GAULAvionique/ABRARACOURCIX_HARD_ware/README.md

# PCB_CTRL_Surface
Le design du hardware qui assurera le contrôle de surface pour le drone prototype.
