GAULAvionique/ABRARACOURCIX_HARD_ware/ABRARACOURCIX_main_board/BOM_ABRARACOURCIX.xlsx

Reference | Quantity | Order quantity | Value | Footprint | Digikey link | Digikey part number | Description
C11 | 1 | 1 | 10u | Librairie_footprint:CAP_MU_15750_RUB-L | https://www.digikey.ca/en/products/detail/rubycon/16MU106MC44532/4969517 | 1189-2511-6-ND | Unpolarized film capacitor
C12 | 1 | 10 | 100nF | Capacitor_SMD:C_1206_3216Metric_Pad1.33x1.80mm_HandSolder | https://www.digikey.ca/en/products/detail/walsin-technology-corporation/1206B104K500CT/9355102 | 1292-1605-1-ND | Unpolarized capacitor
C14, C15 | 2 | 10 | 22pF | Capacitor_SMD:C_1206_3216Metric_Pad1.33x1.80mm_HandSolder | https://www.digikey.ca/en/products/detail/kemet/C1206C220K1GACTU/2215429 | 399-C1206C220K1GACTUCT-ND | Unpolarized capacitor
C17 | 1 | 10 | 1n | Capacitor_SMD:C_1206_3216Metric_Pad1.33x1.80mm_HandSolder | https://www.digikey.ca/en/products/detail/walsin-technology-corporation/1206B102K500CT/9355095 | 1292-1598-1-ND | Unpolarized capacitor
C18 | 1 | 10 | 10u | Capacitor_SMD:C_1206_3216Metric_Pad1.33x1.80mm_HandSolder | https://www.digikey.ca/en/products/detail/walsin-technology-corporation/1206X106K250CT/14836856 | 1292-1206X106K250CT-ND | Unpolarized capacitor
C19, C21 | 2 | 10 | 22u | Capacitor_SMD:C_1206_3216Metric_Pad1.33x1.80mm_HandSolder | https://www.digikey.ca/en/products/detail/walsin-technology-corporation/1206X226M160CT/9341705 | 1292-1206X226M160CT-ND | Unpolarized capacitor
C1-C3, C5, C6, C16 | 6 | 10 | 100n | Capacitor_SMD:C_1206_3216Metric_Pad1.33x1.80mm_HandSolder | Link (https://www.digikey.ca/en/products/detail/walsin-technology-corporation/1206B104K500CT/9355102) | 1292-1605-1-ND | Unpolarized capacitor
C4, C10, C13, C20 | 4 | 10 | 1u | Capacitor_SMD:C_1206_3216Metric_Pad1.33x1.80mm_HandSolder | https://www.digikey.ca/en/products/detail/walsin-technology-corporation/1206B105K250CT/15986617 | 1292-1206B105K250CT-ND | Unpolarized capacitor
C7 | 1 | 10 | 4.7u | Capacitor_SMD:C_1206_3216Metric_Pad1.33x1.80mm_HandSolder | https://www.digikey.ca/en/products/detail/walsin-technology-corporation/1206B475K250CT/14836816 | 1292-1206B475K250CT-ND | Unpolarized capacitor
C8, C9 | 2 | 10 | 2.2u | Capacitor_SMD:C_1206_3216Metric_Pad1.33x1.80mm_HandSolder | https://www.digikey.ca/en/products/detail/walsin-technology-corporation/1206B225K250CT/15980646 | 1292-1206B225K250CT-ND | Unpolarized capacitor
D1, D2 | 2 | 10 | 599-0410-127F | Diode_SMD:D_1206_3216Metric_Pad1.42x1.75mm_HandSolder | https://www.digikey.ca/en/products/detail/dialight/599-0410-127F/21710495 | 350-599-0410-127FCT-ND | Light emitting diode
DZ1 | 1 | 10 | SZMMSZ4679T1G | Diode_SMD:D_SOD-123 | https://www.digikey.ca/en/products/detail/onsemi/SZMMSZ4679T1G/5404986 | SZMMSZ4679T1GOSCT-ND | 18V, 500mW, 5%, Zener diode, MiniMELF
J1 | 1 | 2 | Conn_01x05_Socket | Connector_PinHeader_2.54mm:PinHeader_1x05_P2.54mm_Vertical | https://www.digikey.ca/en/products/detail/sullins-connector-solutions/PPPC051LGBN-RC/775938 | S5480-ND | CONN HDR 5POS 0.1 GOLD PCB R/A
J2 | 1 | 2 | Conn_01x06_Socket | Connector_PinHeader_2.54mm:PinHeader_1x06_P2.54mm_Horizontal | https://www.digikey.ca/en/products/detail/samtec-inc/SSW-106-03-F-S-RA/7893166 | SSW-106-03-F-S-RA-ND | Generic connector, single row, 01x06, script generated
J3-J7 | 5 | 5 | Conn_01x03_Socket | Connector_PinHeader_2.54mm:PinHeader_1x03_P2.54mm_Horizontal | https://www.digikey.ca/en/products/detail/harwin-inc/M20-9960345/3728209 | M20-9960345 | Generic connector, single row, 01x03, script generated
PWR_R1 | 1 | 2 | 100k | Resistor_SMD:R_1206_3216Metric_Pad1.30x1.75mm_HandSolder | https://www.digikey.ca/en/products/detail/bourns-inc/CR1206-JW-104ELF/3741051 | CR1206-JW-104ELFCT-ND | RES SMD 100K OHM 5% 1/4W 1206
Q2 | 1 | 3 | DSS20200L-7-PNP | Package_TO_SOT_SMD:SOT-23-3 | https://www.digikey.ca/en/products/detail/diodes-incorporated/DSS20200L-7/2044514 | DSS20200LDICT-ND | Bipolar transistor symbol for simulation only, substrate tied to the emitter
Q3 | 1 | 2 | IKD15N60R | Package_TO_SOT_SMD:TO-252-2 | https://www.digikey.ca/en/products/detail/infineon-technologies/IKD15N60RATMA1/6131387 | NTR4101PT1GOSCT-ND | N-IGBT transistor, collector/emitter/gate
Q4 | 1 | 3 | NPN-DSS20201L-7 | Package_TO_SOT_SMD:SOT-23 | https://www.digikey.ca/en/products/detail/diodes-incorporated/DSS20201L-7/2044515 | DSS20201LDICT-ND | Bipolar transistor symbol for simulation only, substrate tied to the emitter
Q5 | 1 | 3 | NTR4101PT1G | Package_TO_SOT_SMD:SOT-23-3 | https://www.digikey.ca/en/products/detail/onsemi/NTR4101PT1G/687096 | NTR4101PT1GOSCT-ND | P-MOSFET transistor, drain/source/gate
R1, R15 | 2 | 10 | 40.2 | Resistor_SMD:R_1206_3216Metric_Pad1.30x1.75mm_HandSolder | https://www.digikey.ca/en/products/detail/bourns-inc/CR1206-FX-40R2ELF/2563034 | 118-CR1206-FX-40R2ELFCT-ND | Resistor
R12, R16, R18 | 3 | 10 | 30k | Resistor_SMD:R_1206_3216Metric_Pad1.30x1.75mm_HandSolder | https://www.digikey.ca/en/products/detail/bourns-inc/CR1206-JW-303ELF/3785592 | 118-CR1206-JW-303ELFCT-ND | Resistor
R19 | 1 | 10 | 40.2k | Resistor_SMD:R_1206_3216Metric_Pad1.30x1.75mm_HandSolder | https://www.digikey.ca/en/products/detail/bourns-inc/CR1206-FX-4022ELF/2563031 | 118-CR1206-FX-4022ELFCT-ND | Resistor
R2, R3 | 2 | 10 | 10K | Resistor_SMD:R_1206_3216Metric_Pad1.30x1.75mm_HandSolder | https://www.digikey.ca/en/products/detail/bourns-inc/CR1206-JW-103ELF/3741050 | CR1206-JW-103ELFCT-ND | Resistor
R4 | 1 | 10 | 1K | Resistor_SMD:R_1206_3216Metric_Pad1.30x1.75mm_HandSolder | https://www.digikey.ca/en/products/detail/bourns-inc/CR1206-JW-102ELF/3785514 | 118-CR1206-JW-102ELFCT-ND | Resistor
R5 | 1 | 10 | 1k | Resistor_SMD:R_1206_3216Metric_Pad1.30x1.75mm_HandSolder | https://www.digikey.ca/en/products/detail/bourns-inc/CR1206-JW-102ELF/3785514 | 118-CR1206-JW-102ELFCT-ND | Resistor
R6, R8, R11, R13, R14, R17, R20 | 7 | 10 | 10k | Resistor_SMD:R_1206_3216Metric_Pad1.30x1.75mm_HandSolder | https://www.digikey.ca/en/products/detail/bourns-inc/CR1206-JW-103ELF/3741050 | CR1206-JW-103ELFCT-ND | Resistor
R7, R10 | 2 | 10 | 1k5 | Resistor_SMD:R_1206_3216Metric_Pad1.30x1.75mm_HandSolder | https://www.digikey.ca/en/products/detail/bourns-inc/CR1206-JW-152ELF/3785541 | CR1206-JW-152ELFCT-ND | Resistor
R9 | 1 | 10 | 20k | Resistor_SMD:R_1206_3216Metric_Pad1.30x1.75mm_HandSolder | https://www.digikey.ca/en/products/detail/bourns-inc/CR1206-JW-203ELF/3785565 | 118-CR1206-JW-203ELFCT-ND | RES SMD 20K OHM 5% 1/4W 1206
U1 | 1 | 2 | STM32F429VITx | Package_QFP:LQFP-100_14x14mm_P0.5mm | https://www.digikey.ca/en/products/detail/stmicroelectronics/STM32F429VIT6/4357425 | 497-14052-ND | STMicroelectronics Arm Cortex-M4 MCU, 2048KB flash, 256KB RAM, 180 MHz, 1.8-3.6V, 82 GPIO, LQFP100
U2 | 1 | 2 | BNO055 | Librairie_footprint:BNO055_LGA28R50P4X10_380X520X100 | https://www.digikey.ca/en/products/detail/bosch-sensortec/BNO055/6136301 | 828-1058-1-ND | Inertial Measurement Unit
U3 | 1 | 2 | Current_sens_ACS712ELCTR-20A-T | Librairie_footprint:Current_sens_SOIC127P600X175-8N | https://www.digikey.ca/en/products/detail/allegro-microsystems/ACS712ELCTR-20A-T/1284594 | 620-1190-1-ND | CURRENT SENSOR HE/OL 20A 8-SOIC
U4 | 1 | 10 | AZ1117CH-3.3TRG1 | Librairie_footprint:AZ1117CH_3_3TRG1-L | https://www.digikey.ca/en/products/detail/diodes-incorporated/AZ1117CH-3-3TRG1/4470985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 | AZ1117CH-3.3TRG1DICT-ND | 3v3 LDO
U5, U6 | 2 | 2 | LMC6482AIMX/NOPB | Librairie_footprint:SOIC127P599X175-8N | https://www.digikey.ca/en/products/detail/texas-instruments/LMC6482AIMX-NOPB/3440139 | LMC6482AIMX/NOPBCT-ND | IC CMOS 2 CIRCUIT 8SOIC
Y1 | 1 | 2 | ABS07-32.768KHZ-T | Librairie_footprint:XTAL_ABS07-32.768KHZ-T | https://www.digikey.ca/en/products/detail/abracon-llc/ABS07-32-768KHZ-T/1236858 | 535-9542-1-ND | CRYSTAL 32.7680KHZ 12.5PF SMD
