GAULAvionique/ABRARACOURCIX_HARD_ware/ABRARACOURCIX_main_board/Fichiers3D/microUSB-10118194-0011LF.STEP

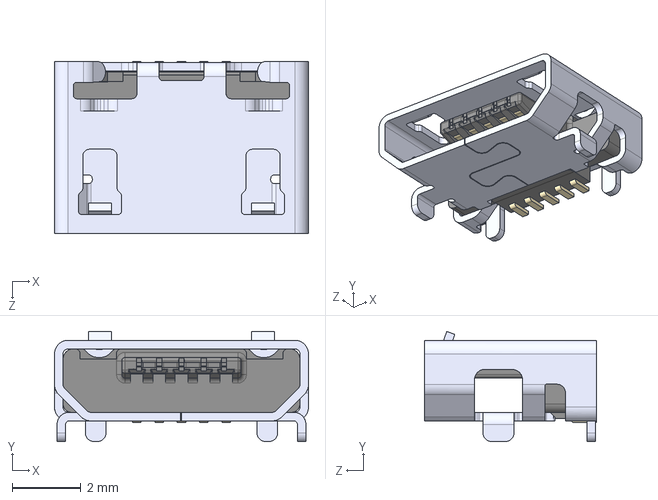
[picture p1: CAD file, 2026-08-21]
ABRARACOURCIX_main_board/Fichiers3D/microUSB-10118194-0011LF.STEP
7.40 x 3.21 x 5.00 mm
