GAULAvionique/ABRARACOURCIX_HARD_ware/ABRARACOURCIX_main_board/Fichiers3D/XT60PW-M--3DModel-STEP-269445.STEP

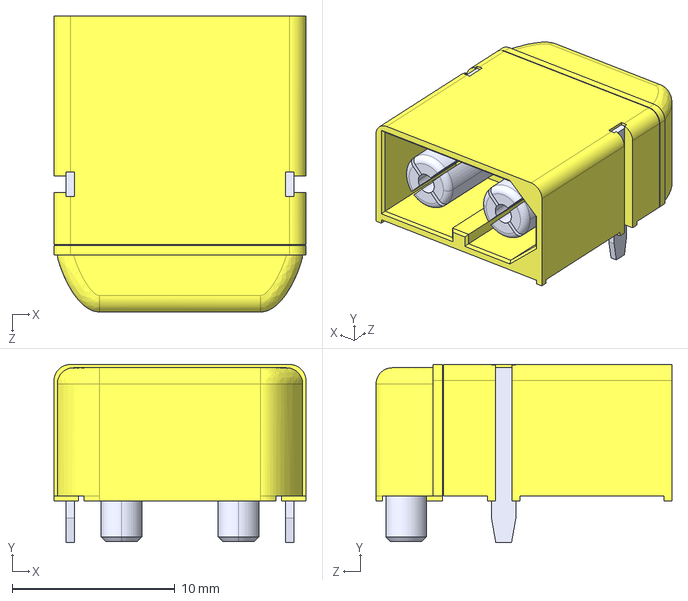
[picture p2: CAD file, 2025-11-12]
ABRARACOURCIX_main_board/Fichiers3D/XT60PW-M--3DModel-STEP-269445.STEP
15.5 x 11.0 x 18.2 mm
