GAULAvionique/ABRARACOURCIX_HARD_ware/ABRARACOURCIX_main_board/Fichiers3D/ABS07-32.768KHZ-T.STEP

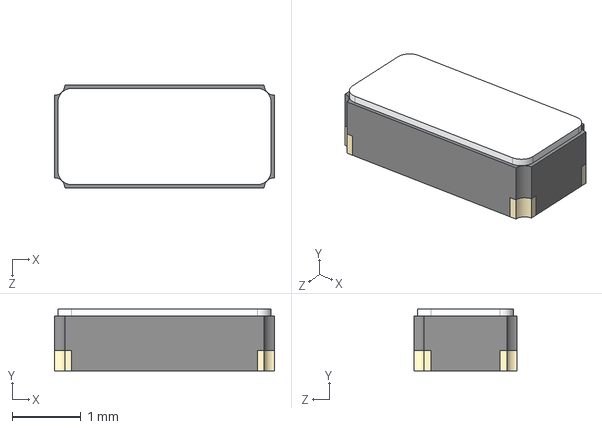
[picture p3: CAD file, 2025-11-12]
ABRARACOURCIX_main_board/Fichiers3D/ABS07-32.768KHZ-T.STEP
3.20 x 0.9 x 1.50 mm
