GAULAvionique/ABRARACOURCIX_HARD_ware/ABRARACOURCIX_main_board/Fichiers3D/CAP_MU_15750_RUB.step

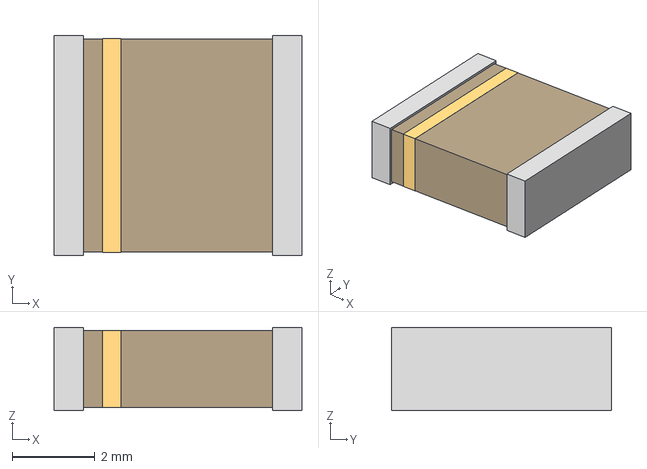
[picture p4: CAD file, 2025-11-12]
ABRARACOURCIX_main_board/Fichiers3D/CAP_MU_15750_RUB.step
5.99 x 5.31 x 2.01 mm
