GAULAvionique/ABRARACOURCIX_HARD_ware/ABRARACOURCIX_main_board/Fichiers3D/XT60PW-F--3DModel-STEP-510211.STEP

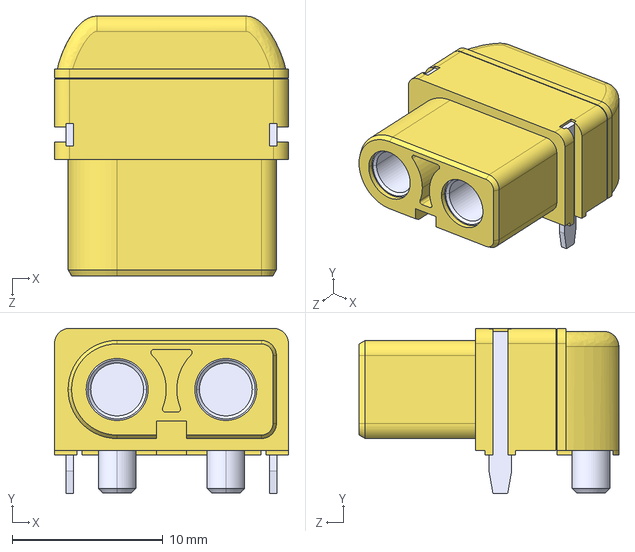
[picture p5: CAD file, 2025-11-12]
ABRARACOURCIX_main_board/Fichiers3D/XT60PW-F--3DModel-STEP-510211.STEP
15.5 x 10.9 x 17.2 mm
