GAULAvionique/ABRARACOURCIX_HARD_ware/ABRARACOURCIX_main_board/Fichiers3D/BNO055.step

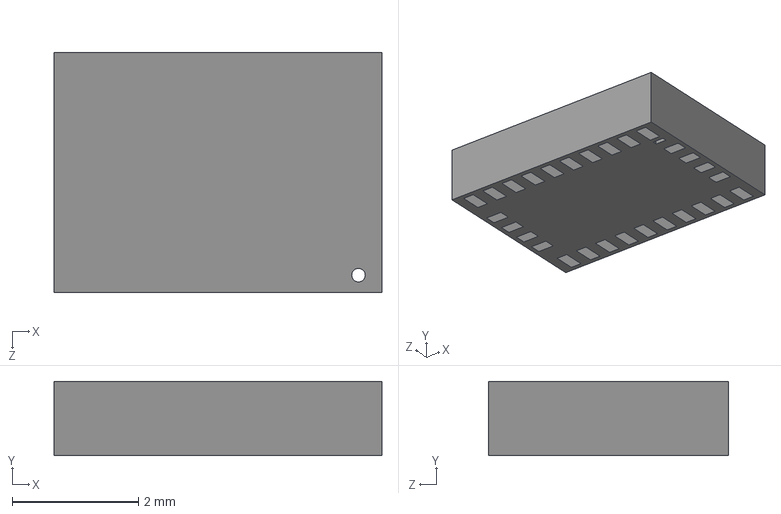
[picture p6: CAD file, 2025-09-26]
ABRARACOURCIX_main_board/Fichiers3D/BNO055.step
5.20 x 1.18 x 3.80 mm
