GAULAvionique/ABRARACOURCIX_HARD_ware/(list of files, cad)

Other CAD files:
ABRARACOURCIX_main_board/Fichiers3D/XT60PW-M.step
