GAULAvionique/ABRARACOURCIX_HARD_ware/ABRARACOURCIX_main_board/ABRARACOURCIX_main_board.kicad_pcb

## KiCad design ABRARACOURCIX_main_board/ABRARACOURCIX_main_board.kicad_pcb (2025-12-05)

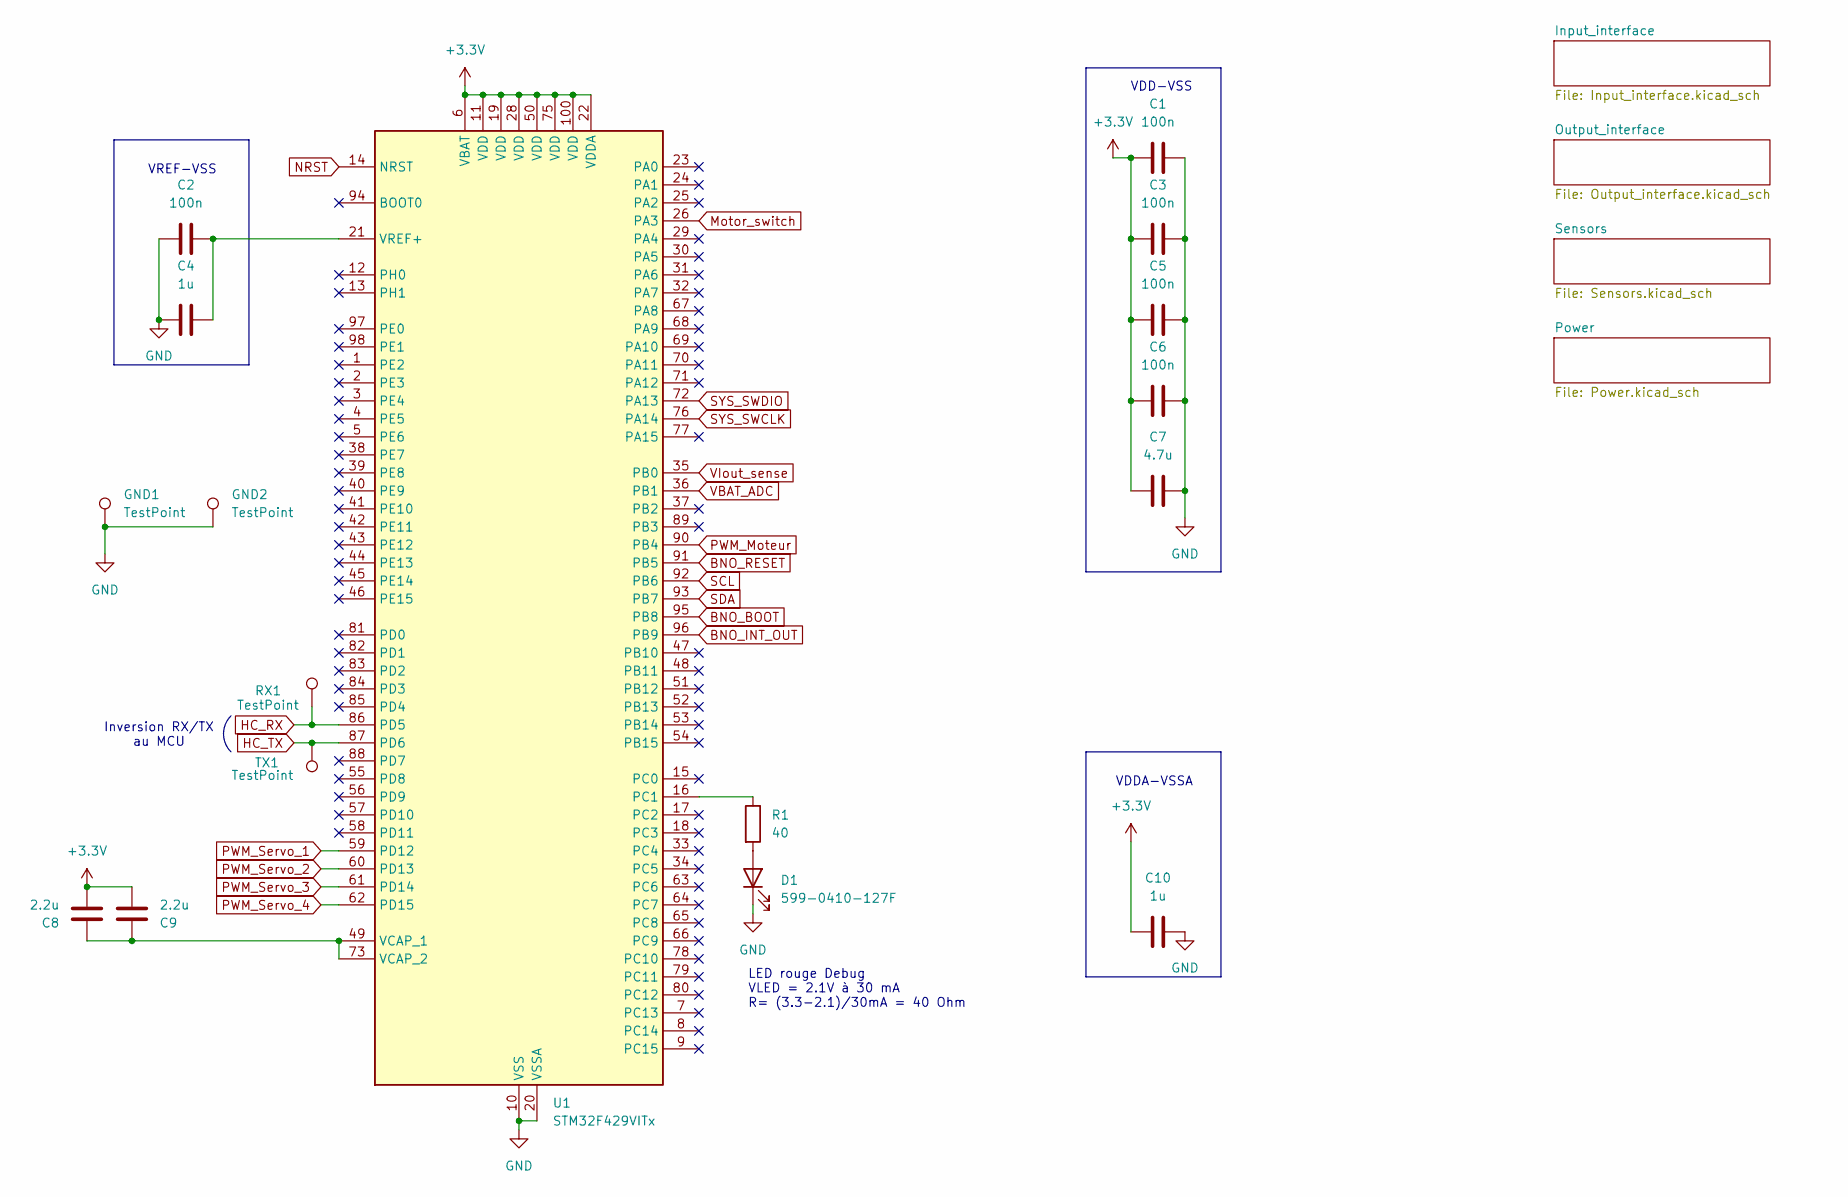
[picture p7: schematic ABRARACOURCIX_main_board.kicad_sch]

Parts:
C1, C2, C3, C5, C6: 100n; C_1206_3216Metric_Pad1.33x1.80mm_HandSolder
C4, C10: 1u; C_1206_3216Metric_Pad1.33x1.80mm_HandSolder
C7: 4.7u; C_1206_3216Metric_Pad1.33x1.80mm_HandSolder
C8, C9: 2.2u; C_1206_3216Metric_Pad1.33x1.80mm_HandSolder
D1: 599-0410-127F; D_1206_3216Metric_Pad1.42x1.75mm_HandSolder
GND1, GND2: TestPoint; TestPoint_THTPad_2.0x2.0mm_Drill1.0mm
R1: 40; R_1206_3216Metric_Pad1.30x1.75mm_HandSolder
RX1: TestPoint; TestPoint_THTPad_2.0x2.0mm_Drill1.0mm
TX1: TestPoint; TestPoint_THTPad_2.0x2.0mm_Drill1.0mm
U1: STM32F429VITx; LQFP-100_14x14mm_P0.5mm

Connections:
+3.3V: C1.1, C3.1, C5.1, C6.1, C7.1, C8.2, C9.2, C10.1, U1.6 (VBAT), U1.11 (VDD), U1.19 (VDD), U1.22 (VDDA), U1.28 (VDD), U1.50 (VDD), U1.75 (VDD), U1.100 (VDD); also elsewhere on the board
BNO_BOOT: U1.95 (PB8); also elsewhere on the board
BNO_INT_OUT: U1.96 (PB9); also elsewhere on the board
BNO_RESET: U1.91 (PB5); also elsewhere on the board
HC_RX: RX1.1, U1.86 (PD5); also elsewhere on the board
HC_TX: TX1.1, U1.87 (PD6); also elsewhere on the board
Motor_switch: U1.26 (PA3); also elsewhere on the board
NRST: U1.14 (NRST); also elsewhere on the board
unnamed: D1.2 (A), R1.2
unnamed: R1.1, U1.16 (PC1)
unnamed: C8.1, C9.1, U1.49 (VCAP_1), U1.73 (VCAP_2)
unnamed: C2.2, C4.2, U1.21 (VREF+)
PWM_Moteur: U1.90 (PB4); also elsewhere on the board
PWM_Servo_1: U1.59 (PD12); also elsewhere on the board
PWM_Servo_2: U1.60 (PD13); also elsewhere on the board
PWM_Servo_3: U1.61 (PD14); also elsewhere on the board
PWM_Servo_4: U1.62 (PD15); also elsewhere on the board
SCL: U1.92 (PB6); also elsewhere on the board
SDA: U1.93 (PB7); also elsewhere on the board
SYS_SWCLK: U1.76 (PA14); also elsewhere on the board
SYS_SWDIO: U1.72 (PA13); also elsewhere on the board
VBAT_ADC: U1.36 (PB1); also elsewhere on the board
VIout_sense: U1.35 (PB0); also elsewhere on the board

Notes on the sheet:
VDDA-VSSA
VDD-VSS
Inversion RX/TX au MCU
LED rouge Debug VLED = 2.1V à 30 mA R= (3.3-2.1)/30mA = 40 Ohm
VREF-VSS

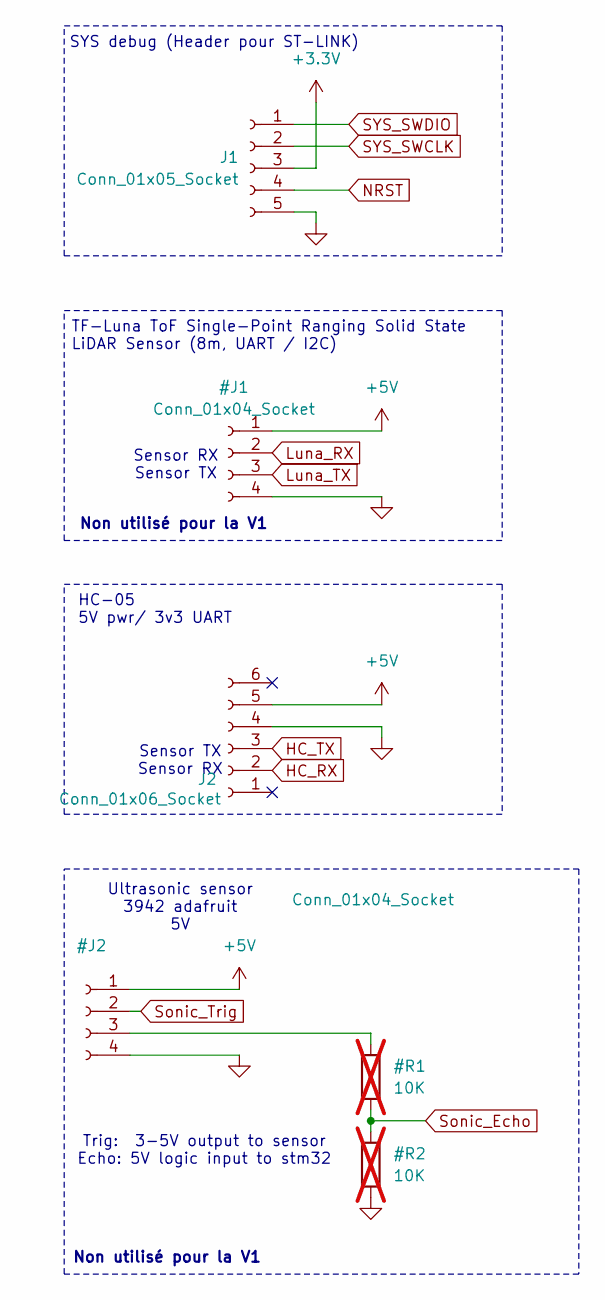
[picture p8: schematic Input_interface.kicad_sch]

Parts:
J1: Conn_01x05_Socket; PinHeader_1x05_P2.54mm_Vertical; Part number S5480-ND
J2: Conn_01x06_Socket; PinHeader_1x06_P2.54mm_Horizontal; Part number SSW-106-03-F-S-RA-ND

Connections:
+3.3V: J1.3; also elsewhere on the board
HC_RX: J2.2; also elsewhere on the board
HC_TX: J2.3; also elsewhere on the board
NRST: J1.4; also elsewhere on the board
SYS_SWCLK: J1.2; also elsewhere on the board
SYS_SWDIO: J1.1; also elsewhere on the board

Notes on the sheet:
Sensor TX Sensor RX
HC-05 5V pwr/ 3v3 UART
SYS debug (Header pour ST-LINK)
Non utilisé pour la V1
Sensor RX Sensor TX
Trig: 3-5V output to sensor Echo: 5V logic input to stm32
Ultrasonic sensor 3942 adafruit 5V
TF-Luna ToF Single-Point Ranging Solid State LiDAR Sensor (8m, UART / I2C)

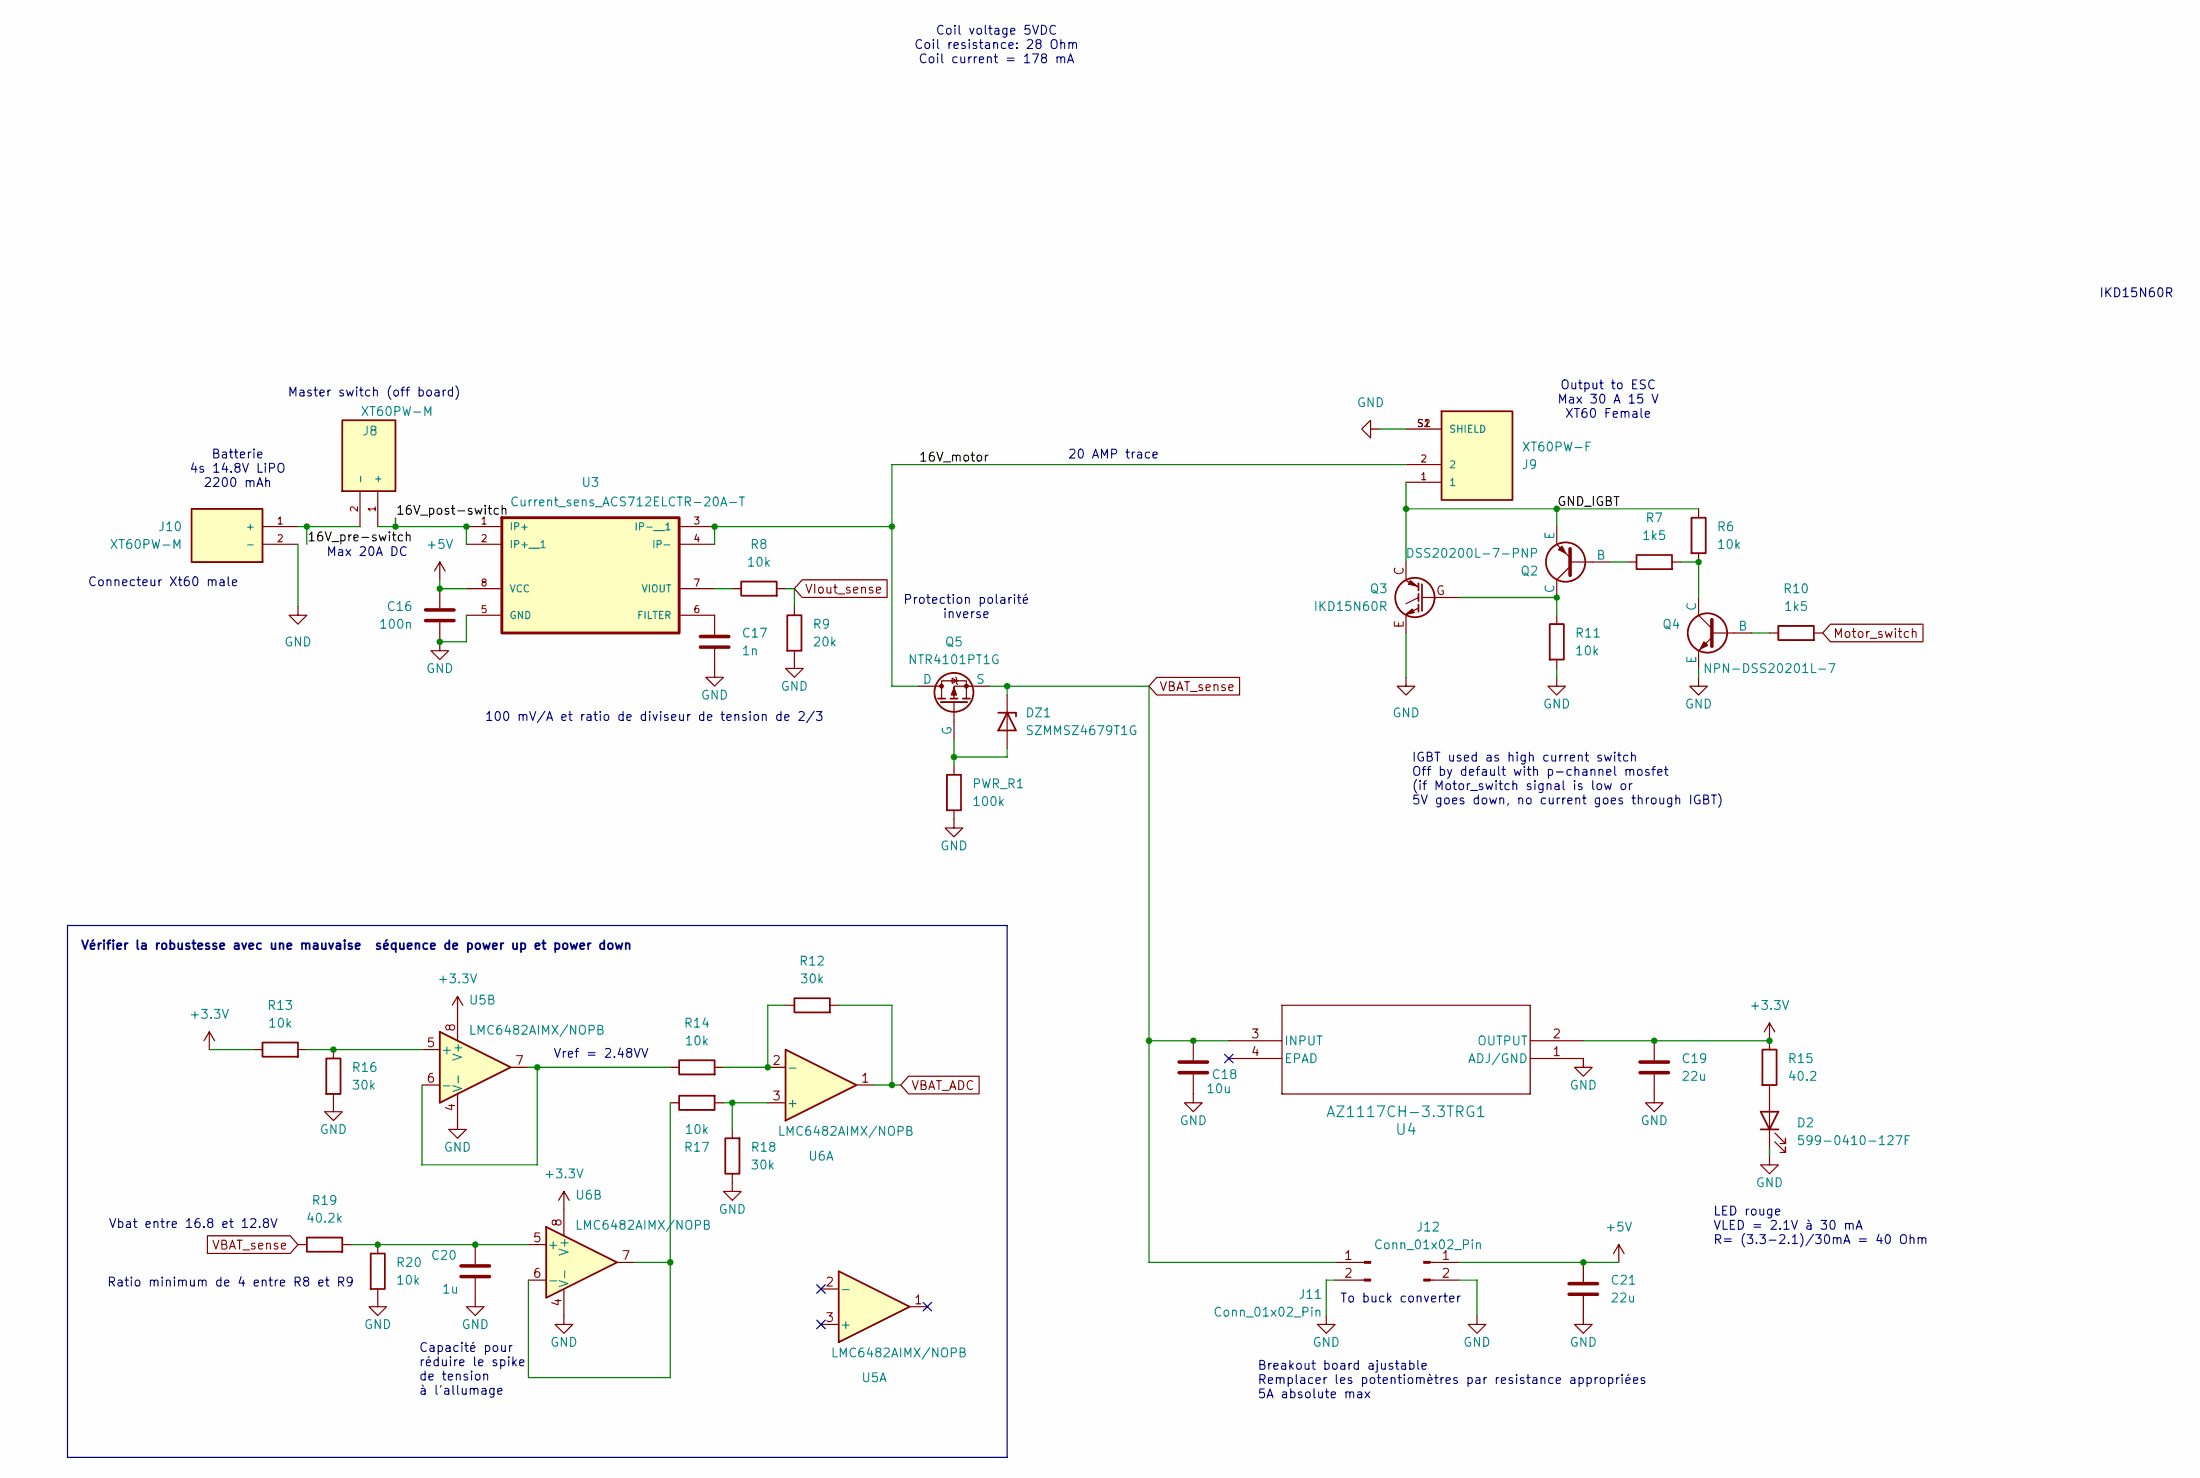
[picture p9: schematic Power.kicad_sch]

Parts:
C16: 100n; C_1206_3216Metric_Pad1.33x1.80mm_HandSolder; Part number 1292-1605-1-ND
C17: 1n; C_1206_3216Metric_Pad1.33x1.80mm_HandSolder; Part number 1292-1598-1-ND
C18: 10u; C_1206_3216Metric_Pad1.33x1.80mm_HandSolder; Part number 1292-1206X106K250CT-ND
C19, C21: 22u; C_1206_3216Metric_Pad1.33x1.80mm_HandSolder; Part number 1292-1206X226M160CT-ND
C20: 1u; C_1206_3216Metric_Pad1.33x1.80mm_HandSolder; Part number 1292-1206B105K250CT-ND
D2: 599-0410-127F; D_1206_3216Metric_Pad1.42x1.75mm_HandSolder; Part number 350-599-0410-127FCT-ND
DZ1: SZMMSZ4679T1G; D_SOD-123; Part number SZMMSZ4679T1GOSCT-ND
J8: XT60PW-M; AMASS_XT60-F_1x02_P7.20mm_Vertical; PARTREV V1.2
J9: XT60PW-F; AMASS_XT60PW-F; PARTREV V1.2
J10: XT60PW-M; AMASS_XT60PW-M; PARTREV V1.2
J11, J12: Conn_01x02_Pin; MTA_100_2pos
PWR_R1: 100k; R_1206_3216Metric_Pad1.30x1.75mm_HandSolder; Part number CR1206-JW-104ELFCT-ND
Q2: DSS20200L-7-PNP; SOT-23-3; Part number DSS20200LDICT-ND
Q3: IKD15N60R; TO-252-2; Part number NTR4101PT1GOSCT-ND
Q4: NPN-DSS20201L-7; SOT-23; Part number DSS20201LDICT-ND
Q5: NTR4101PT1G; SOT-23-3; Part number NTR4101PT1GOSCT-ND
R6, R8, R11, R13, R14, R17, R20: 10k; R_1206_3216Metric_Pad1.30x1.75mm_HandSolder; Part number CR1206-JW-103ELFCT-ND
R7, R10: 1k5; R_1206_3216Metric_Pad1.30x1.75mm_HandSolder; Part number CR1206-JW-152ELFCT-ND
R9: 20k; R_1206_3216Metric_Pad1.30x1.75mm_HandSolder; Part number 118-CR1206-JW-203ELFCT-ND
R12, R16, R18: 30k; R_1206_3216Metric_Pad1.30x1.75mm_HandSolder; Part number 118-CR1206-JW-303ELFCT-ND
R15: 40.2; R_1206_3216Metric_Pad1.30x1.75mm_HandSolder; Part number 118-CR1206-FX-40R2ELFCT-ND
R19: 40.2k; R_1206_3216Metric_Pad1.30x1.75mm_HandSolder; Part number 118-CR1206-FX-4022ELFCT-ND
U3: Current_sens_ACS712ELCTR-20A-T; Current_sens_SOIC127P600X175-8N; Part number 620-1190-1-ND
U4: AZ1117CH-3.3TRG1; AZ1117CH_3_3TRG1-L; Part number AZ1117CH-3.3TRG1DICT-ND
U5, U6: LMC6482AIMX/NOPB; SOIC127P599X175-8N; Part number LMC6482AIMX/NOPBCT-ND

Connections:
+3.3V: C19.1, R13.1, R15.1, U4.2 (OUTPUT), U5.8 (V+), U6.8 (V+); also elsewhere on the board
/Power/16V_motor: J9.2, Q5.D, U3.3 (IP-__1), U3.4 (IP-)
/Power/16V_post-switch: J8.1 (+), U3.1 (IP+), U3.2 (IP+__1)
/Power/16V_pre-switch: J8.2 (-), J10.1 (+)
/Power/GND_IGBT: J9.1, Q2.E, Q3.C, R6.1
Motor_switch: R10.2; also elsewhere on the board
unnamed: D2.2 (A), R15.2
unnamed: DZ1.2 (A), PWR_R1.1, Q5.G
unnamed: Q2.B, R7.1
unnamed: Q2.C, Q3.G, R11.1
unnamed: Q4.B, R10.1
unnamed: Q4.C, R6.2, R7.2
unnamed: C17.1, U3.6 (FILTER)
unnamed: R8.1, U3.7 (VIOUT)
unnamed: R13.2, R16.1, U5.5 (+)
unnamed: R14.1, U5.6 (-), U5.7
unnamed: R17.2, R18.2, U6.3 (+)
unnamed: R12.1, R14.2, U6.2 (-)
unnamed: C20.1, R19.2, R20.1, U6.5 (+)
unnamed: R17.1, U6.6 (-), U6.7
VBAT_ADC: R12.2, U6.1; also elsewhere on the board
VBAT_sense: C18.1, DZ1.1 (K), J11.1, Q5.S, R19.1, U4.3 (INPUT)
VIout_sense: R8.2, R9.1; also elsewhere on the board

Notes on the sheet:
IGBT used as high current switch Off by default with p-channel mosfet (if Motor_switch signal is low or 5V goes down, no current goes through IGBT)
Capacité pour réduire le spike de tension à l'allumage
To buck converter
Batterie 4s 14.8V LiPO 2200 mAh
Vérifier la robustesse avec une mauvaise séquence de power up et power down
Coil voltage 5VDC Coil resistance: 28 Ohm Coil current = 178 mA
Vbat entre 16.8 et 12.8V
IKD15N60R
Output to ESC Max 30 A 15 V XT60 Female
Connecteur Xt60 male
20 AMP trace
Max 20A DC
100 mV/A et ratio de diviseur de tension de 2/3
Master switch (off board)
Ratio minimum de 4 entre R8 et R9
LED rouge VLED = 2.1V à 30 mA R= (3.3-2.1)/30mA = 40 Ohm
Vref = 2.48VV
Protection polarité inverse
Breakout board ajustable Remplacer les potentiomètres par resistance appropriées 5A absolute max

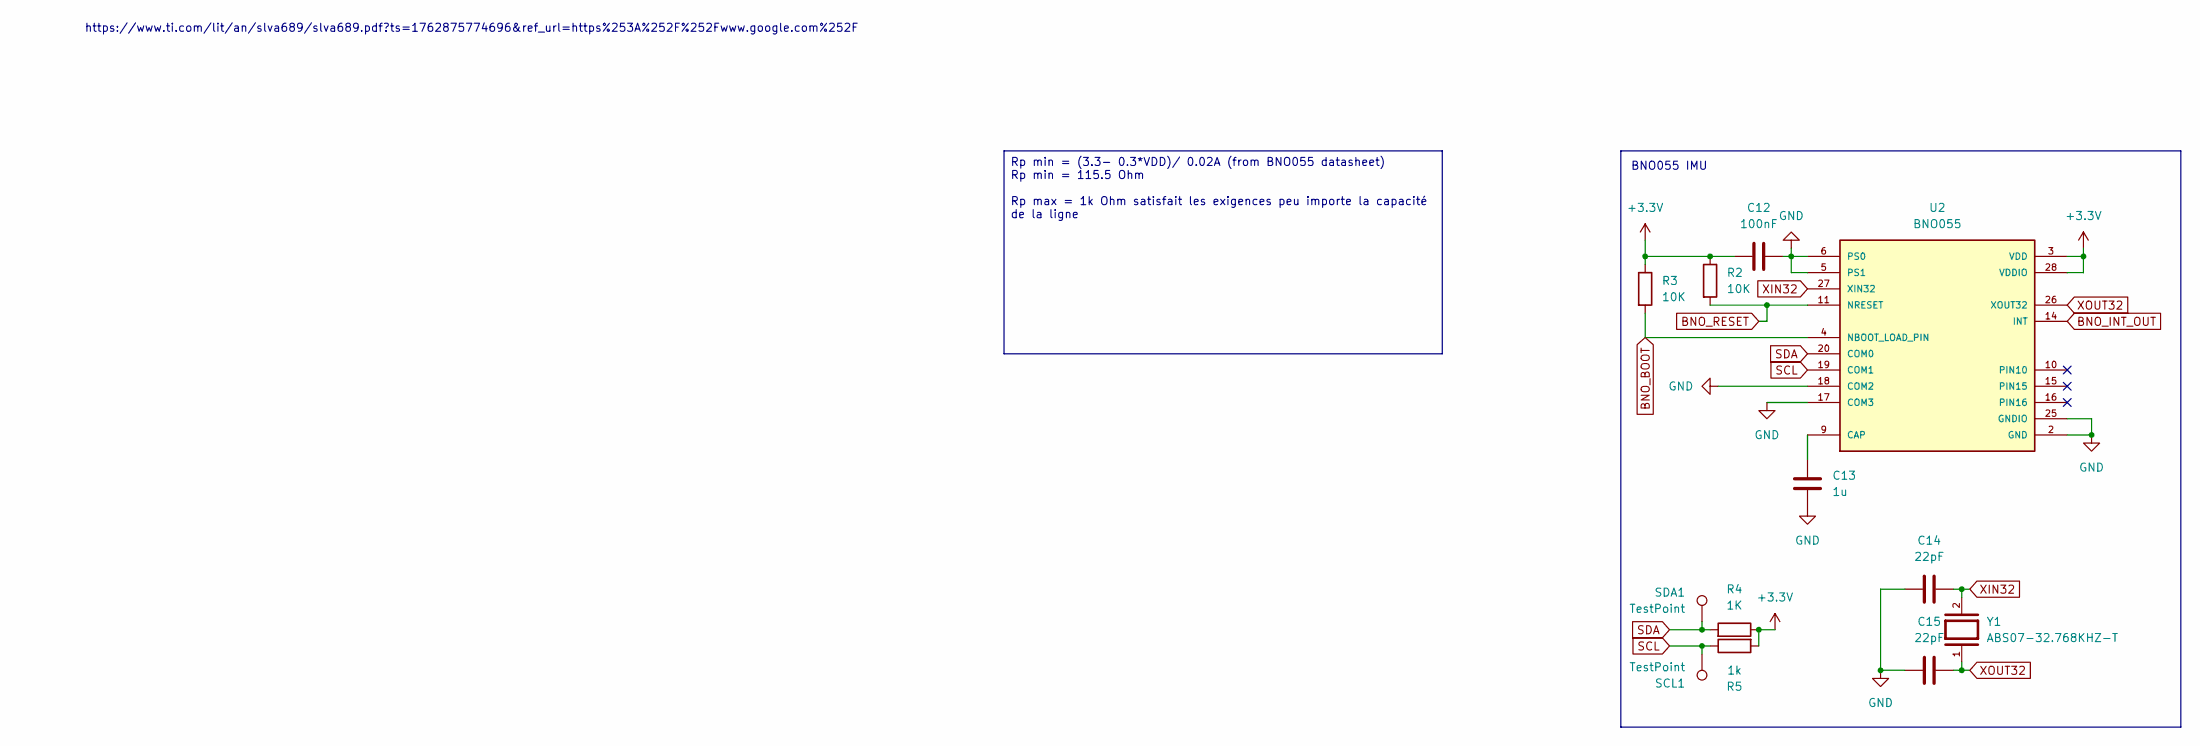
[picture p10: schematic Sensors.kicad_sch]

Parts:
C12: 100nF; C_1206_3216Metric_Pad1.33x1.80mm_HandSolder; Part number 1292-1605-1-ND
C13: 1u; C_1206_3216Metric_Pad1.33x1.80mm_HandSolder; Part number 1292-1206B105K250CT-ND
C14, C15: 22pF; C_1206_3216Metric_Pad1.33x1.80mm_HandSolder; Part number 399-C1206C220K1GACTUCT-ND
R2, R3: 10K; R_1206_3216Metric_Pad1.30x1.75mm_HandSolder; Part number CR1206-JW-103ELFCT-ND
R4: 1K; R_1206_3216Metric_Pad1.30x1.75mm_HandSolder; Part number 118-CR1206-JW-102ELFCT-ND
R5: 1k; R_1206_3216Metric_Pad1.30x1.75mm_HandSolder; Part number 118-CR1206-JW-102ELFCT-ND
SCL1: TestPoint; TestPoint_THTPad_2.0x2.0mm_Drill1.0mm
SDA1: TestPoint; TestPoint_THTPad_2.0x2.0mm_Drill1.0mm
U2: BNO055; BNO055_LGA28R50P4X10_380X520X100; Part number 828-1058-1-ND
Y1: ABS07-32.768KHZ-T; XTAL_ABS07-32.768KHZ-T; PARTREV 08.19.15

Connections:
+3.3V: C12.2, R2.1, R3.1, R4.1, R5.2, U2.3 (VDD), U2.28 (VDDIO); also elsewhere on the board
BNO_BOOT: R3.2, U2.4 (NBOOT_LOAD_PIN); also elsewhere on the board
BNO_INT_OUT: U2.14 (INT); also elsewhere on the board
BNO_RESET: R2.2, U2.11 (NRESET); also elsewhere on the board
unnamed: C13.2, U2.9 (CAP)
SCL: R5.1, SCL1.1, U2.19 (COM1); also elsewhere on the board
SDA: R4.2, SDA1.1, U2.20 (COM0); also elsewhere on the board
XIN32: C14.1, U2.27 (XIN32), Y1.2

Notes on the sheet:
BNO055 IMU
https://www.ti.com/lit/an/slva689/slva689.pdf?ts=1762875774696&ref_url=https%253A%252F%252Fwww.google.com%252F
Rp min = (3.3- 0.3*VDD)/ 0.02A (from BNO055 datasheet) Rp min = 115.5 Ohm Rp max = 1k Ohm satisfait les exigences peu importe la capacité de la ligne

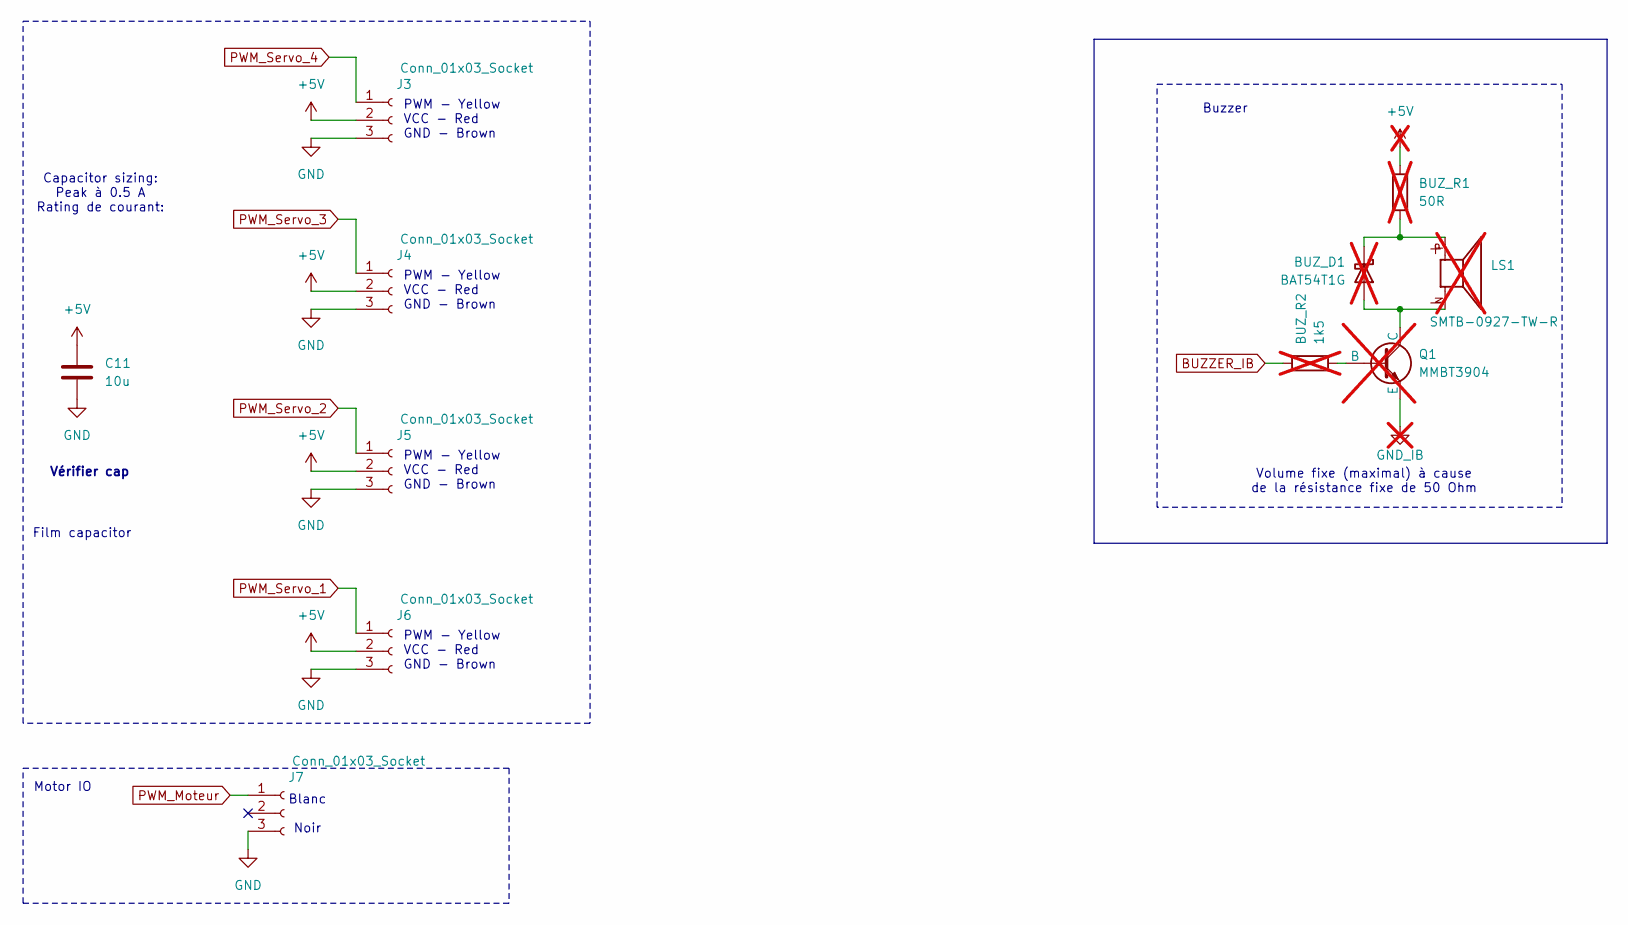
[picture p11: schematic Output_interface.kicad_sch]

Parts:
BUZ_D1: BAT54T1G; D_SOD-123; Digikey BAT54T1GOSCT-ND; not fitted
BUZ_R1: 50R; R_1206_3216Metric_Pad1.30x1.75mm_HandSolder; Digikey 541-TNPW120650R0BEENCT-ND; not fitted
BUZ_R2: 1k5; R_1206_3216Metric_Pad1.30x1.75mm_HandSolder; Digikey 541-4184-1-ND; not fitted
C11: 10u; CAP_MU_15750_RUB-L; Part number 1189-2511-6-ND
J3, J4, J5, J6, J7: Conn_01x03_Socket; PinHeader_1x03_P2.54mm_Horizontal; Part number M20-9960345
LS1: SMTB-0927-TW-R; XDCR_SMTB-0927-TW-R; PARTREV 6/1/17; not fitted
Q1: MMBT3904; SOT-23; Digikey MMBT3904LT1GOSCT-ND; not fitted

Connections:
unnamed: BUZ_D1.1 (K), BUZ_R1.1, LS1.P
unnamed: BUZ_D1.2 (A), LS1.N, Q1.1 (C)
unnamed: BUZ_R2.2, Q1.2 (B)
PWM_Moteur: J7.1; also elsewhere on the board
PWM_Servo_1: J6.1; also elsewhere on the board
PWM_Servo_2: J5.1; also elsewhere on the board
PWM_Servo_3: J4.1; also elsewhere on the board
PWM_Servo_4: J3.1; also elsewhere on the board

Notes on the sheet:
Blanc Noir
Volume fixe (maximal) à cause de la résistance fixe de 50 Ohm
PWM - Yellow VCC - Red GND - Brown
Film capacitor
Buzzer
Capacitor sizing: Peak à 0.5 A Rating de courant:
Vérifier cap
Motor IO

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
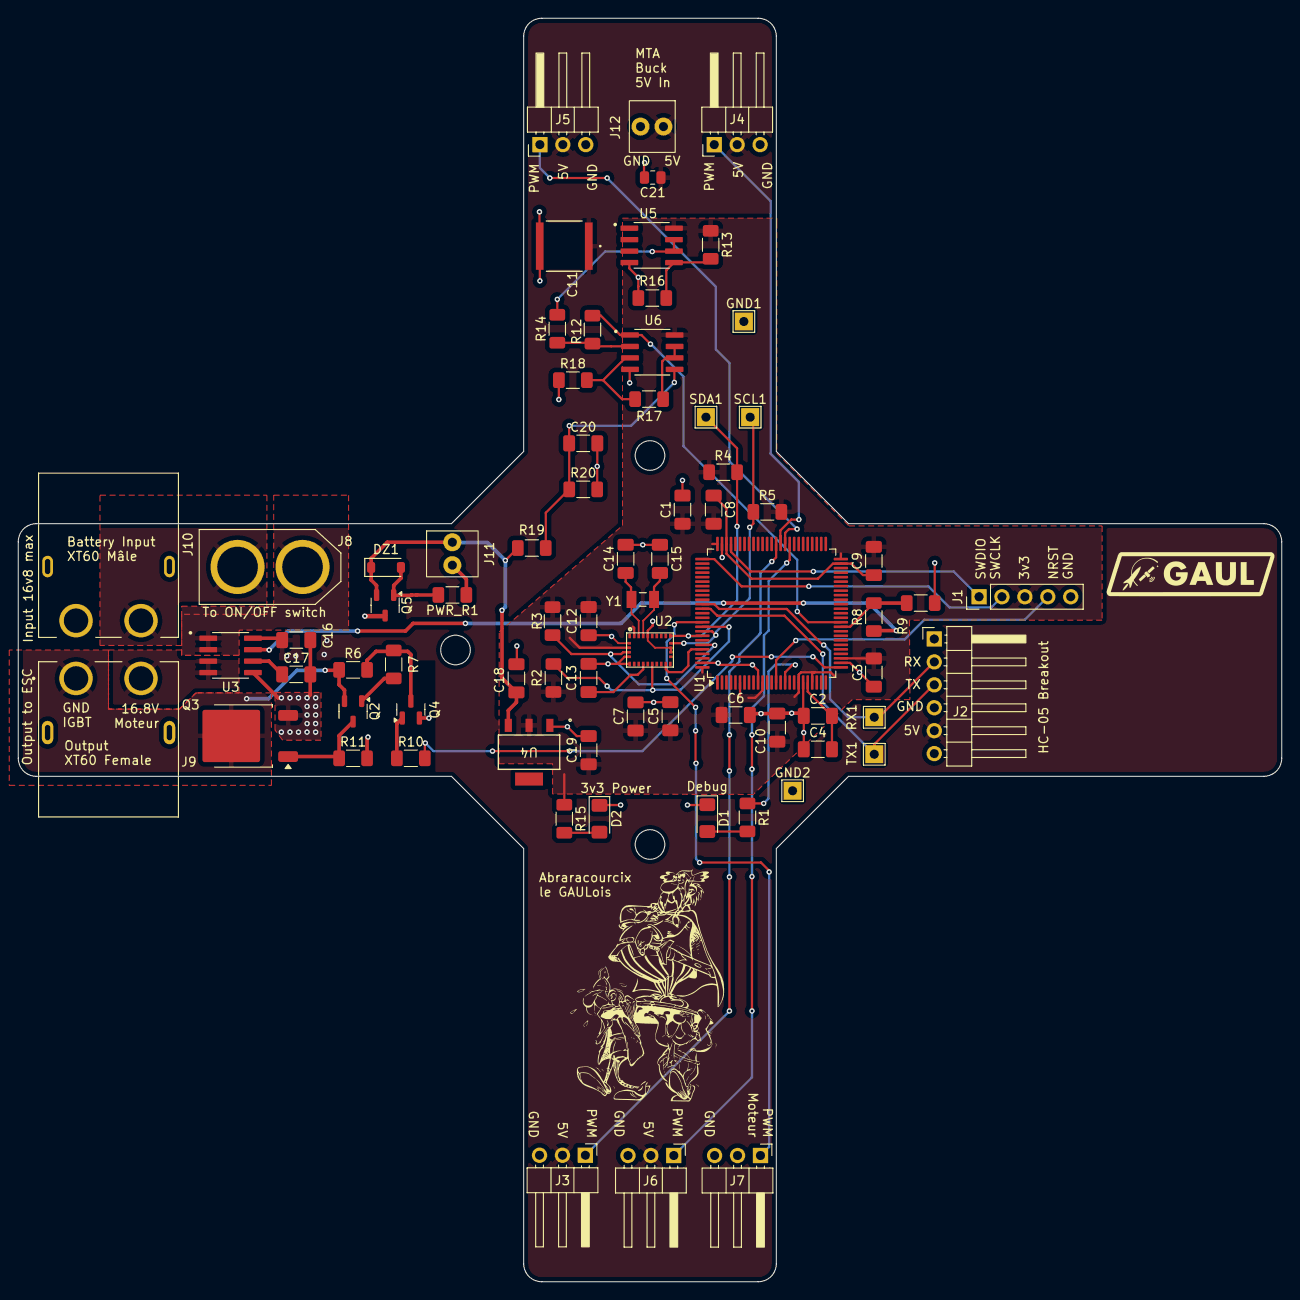
[picture p12: board ABRARACOURCIX_main_board.kicad_pcb from above]

Board: 2 copper layers, 140.0 x 140.0 mm, 75 parts (0 on the bottom side), 47 nets.

Other parts of the board:
Abraracourcix_moyen: LOGO; Abraracourcix_moyen
