GAULAvionique/ABRARACOURCIX_HARD_ware/ABRARACOURCIX_main_board/HM-10_proto_board/HM-10_proto_board/HM-10_proto_board.kicad_pcb

## KiCad design ABRARACOURCIX_main_board/HM-10_proto_board/HM-10_proto_board/HM-10_proto_board.kicad_pcb (2025-10-03)

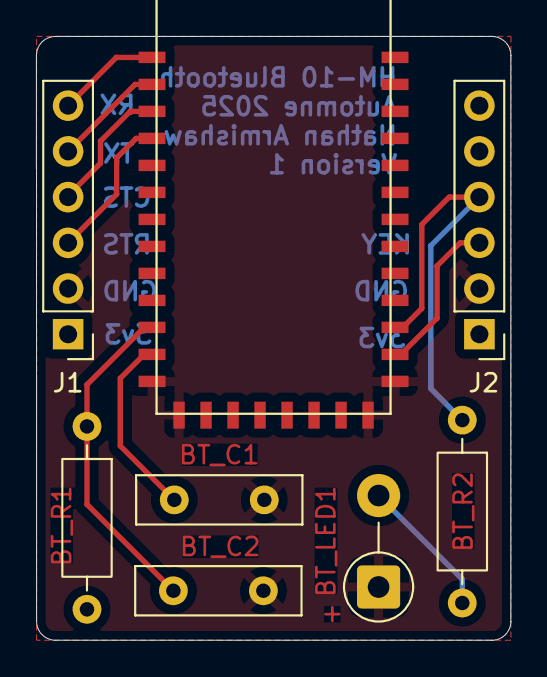
[picture p13: board HM-10_proto_board.kicad_pcb from above]

Board: 2 copper layers, 26.4 x 33.5 mm, 8 parts (0 on the bottom side), 10 nets.

Parts:
BT_C1: 10uF; C_Disc_D9.0mm_W2.5mm_P5.00mm
BT_C2: 100nF; C_Disc_D9.0mm_W2.5mm_P5.00mm
BT_LED1: BLUE; D_DO-15_P5.08mm_Vertical_AnodeUp
BT_R1: 10k; R_Axial_DIN0207_L6.3mm_D2.5mm_P10.16mm_Horizontal
BT_R2: 1k5; R_Axial_DIN0207_L6.3mm_D2.5mm_P10.16mm_Horizontal
E2: HM-10
J1, J2: Conn_01x06_Socket; PinHeader_1x06_P2.54mm_Vertical

Connections:
+3V3: BT_C1.1, BT_R1.2, E2.12 (+3.3V), J1.1, J2.1
BT_Config/Run: E2.23 (KEY), J2.3
GND: BT_C1.2, BT_C2.2, BT_LED1.1 (K), E2.13 (GND), E2.14 (GND__1), E2.21 (GND__2), E2.22 (GND__3), J1.2, J2.2
unnamed: BT_LED1.2 (A), BT_R2.2
unnamed: BT_R2.1, E2.24 (LED), J2.4
unnamed: BT_C2.1, BT_R1.1, E2.11 (RESET)
UART2_BT_RX: E2.1 (UART_TX), J1.6
UART2_BT_TX: E2.2 (UART_RX), J1.5
UART_CTS: E2.3 (UART_CTS), J1.4
UART_RTS: E2.4 (UART_RTS), J1.3
