GAULAvionique/ABRARACOURCIX_HARD_ware/(commit log)

2025-09-05 Création des docs
    [ABRARACOURCIX_main_board.kicad_pcb, ABRARACOURCIX_main_board.kicad_sch]
2025-09-10 Importation des librairies
    Librairies des composantes principales
    Reste à ajouter l'IO
    [ABRARACOURCIX_main_board.kicad_sch, Input_interface.kicad_sch, Output_interface.kicad_sch, Power.kicad_sch, SMTB-0927-TW-R.STEP, Sensors.kicad_sch]
2025-09-11 Terminé les interconnects
    Toutes les interfaces et le power sont terminés. (À vérifier)
    Reste à ajouter toutes les connexions au ICM et stm32
    [Input_interface.kicad_sch, Output_interface.kicad_sch, Power.kicad_sch, XT60PW-M.step]
2025-09-12 Avancement
    Decoupling caps
    Changement de stm32
    [ABRARACOURCIX_main_board.kicad_sch, Sensors.kicad_sch]
2025-09-23 Commit de kicad
    [Sensors.kicad_sch]
2025-09-23 commit de git
2025-09-26 Changements obsolete
    [HM-10_proto_board.kicad_pcb, HM-10_proto_board.kicad_sch, Input_interface.kicad_sch, Output_interface.kicad_sch, Sensors.kicad_sch]
2025-09-26 Création d'un board pour le HM10
    [HM-10_proto_board.kicad_pcb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]
2025-09-26 Avancement
    Commencer à relier le stm32
    [ABRARACOURCIX_main_board.kicad_sch, BNO055.step, Input_interface.kicad_sch]
2025-10-03 Correction des erreurs de merge dans branche Nathan
2025-10-03 Correction du schematic
    [HM-10_proto_board.kicad_sch]
2025-10-03 Correction du fichier pcb
    [HM-10_proto_board.kicad_pcb]
2025-11-10 début pcb
    [ABRARACOURCIX_main_board.kicad_pcb, ABRARACOURCIX_main_board.kicad_sch, BNO055.step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]
2025-11-11 Modifs au circuit d'alim
    [ABRARACOURCIX_main_board.kicad_pcb, ABRARACOURCIX_main_board.kicad_sch, Output_interface.kicad_sch, Power.kicad_sch, Sensors.kicad_sch]
2025-11-11 Modif circuit d'arrêt
    [Output_interface.kicad_sch, Power.kicad_sch]
2025-11-11 Placement des composantes 95%
    [ABRARACOURCIX_main_board.kicad_pcb, ABRARACOURCIX_main_board.kicad_sch, Input_interface.kicad_sch, Output_interface.kicad_sch, Power.kicad_sch]
2025-11-12 Documentation de composantes
    [ABRARACOURCIX_main_board.kicad_pcb, ABRARACOURCIX_main_board.kicad_sch, ABS07-32.768KHZ-T.STEP, BNO055.step, CAP_MU_15750_RUB.step, Input_interface.kicad_sch, LMC6482AIMX_NOPB.step, Output_interface.kicad_sch]
2025-11-13 Déplacement des mounting holes et début du routing
    [ABRARACOURCIX_main_board.kicad_pcb, Power.kicad_sch]
2025-11-13 Avancement routing section power
    [ABRARACOURCIX_main_board.kicad_pcb]
2025-11-14 Routing terminé (v1)
    [ABRARACOURCIX_main_board.csv, ABRARACOURCIX_main_board.kicad_pcb, ABRARACOURCIX_main_board.kicad_sch, Input_interface.kicad_sch, Output_interface.kicad_sch, Power.kicad_sch, Sensors.kicad_sch]
2025-11-16 Ajout de dessins et info silkscreen
    [ABRARACOURCIX_main_board.kicad_pcb]
2025-11-16 Recommencer assignation des composantes
    [ABRARACOURCIX_main_board.csv, ABRARACOURCIX_main_board.kicad_pcb, ABRARACOURCIX_main_board.kicad_sch, ABS07-32.768KHZ-T.STEP, BNO055.step, CAP_MU_15750_RUB.step, HM-10_proto_board.kicad_pcb, HM-10_proto_board.kicad_sch]
2025-11-20 Documentation, lien digikey et part number assigné à toutes les composantes
    [ABRARACOURCIX_main_board-B_Cu.gbr, ABRARACOURCIX_main_board-B_Mask.gbr, ABRARACOURCIX_main_board-B_Paste.gbr, ABRARACOURCIX_main_board-B_Silkscreen.gbr, ABRARACOURCIX_main_board-Edge_Cuts.gbr, ABRARACOURCIX_main_board-F_Cu.gbr, ABRARACOURCIX_main_board-F_Mask.gbr, ABRARACOURCIX_main_board-F_Paste.gbr]
2025-12-05 Liste des modifs pour la V2
    [ABRARACOURCIX_main_board.kicad_pcb, Power.kicad_sch]
